Umi4Life/DP65/DP65_PCB/DP65.csv

Reference | Qty | Value | LCSC | DNP | Exclude from BOM | Exclude from Board | Footprint | Datasheet
K_PIPE1,K_TAB1 | 2 | choc_v1_SW_HS | C5333465 |  |  |  | PCM_Switch_Keyboard_Hotswap_Kailh:SW_Hotswap_Kailh_Choc_V1V2_1.50u | ~
K_ENTER1,K_SHIFT1,K_SPACE_L1,K_SPACE_R1 | 4 | choc_v1_SW_HS | C5333465 |  |  |  | PCM_Switch_Keyboard_Hotswap_Kailh:SW_Hotswap_Kailh_Choc_V1V2_2.25u | ~
K_CAPS1,K_SHIFT2 | 2 | choc_v1_SW_HS | C5333465 |  |  |  | PCM_Switch_Keyboard_Hotswap_Kailh:SW_Hotswap_Kailh_Choc_V1V2_1.75u | ~
K_BACKSPACE1 | 1 | choc_v1_SW_HS | C5333465 |  |  |  | PCM_Switch_Keyboard_Hotswap_Kailh:SW_Hotswap_Kailh_Choc_V1V2_2.00u | ~
K_ALT_L1,K_ALT_R1,K_CRTL1,K_FN1,K_FN2,K_WIN1 | 6 | choc_v1_SW_HS | C5333465 |  |  |  | PCM_Switch_Keyboard_Hotswap_Kailh:SW_Hotswap_Kailh_Choc_V1V2_1.25u | ~
K_0,K_1,K_2,K_3,K_4,K_5,K_6,K_7,K_8,K_9,K_A1,K_B1,K_C1,K_COMMA1,K_D1,K_DOWN_ARR1,K_E1,K_ESC1,K_F1,K_G1,K_H1,K_I1,K_J1,K_K1,K_L1,K_LEFT_ARR1,K_L_BRAC1,K_M1,K_MINUS1,K_N1,K_O1,K_P1,K_PERIOD1,K_PLUS1,K_Q1,K_QUOTE1,K_R1,K_RIGHT_ARR1,K_R_BRAC1,K_S1,K_SEMICOLON1,K_SLASH1,K_T1,K_U1,K_UP_ARR1,K_V1,K_W1,K_X1,K_Y1,K_Z1 | 50 | choc_v1_SW_HS | C5333465 |  |  |  | PCM_Switch_Keyboard_Hotswap_Kailh:SW_Hotswap_Kailh_Choc_V1V2_1.00u | ~
ENC_LEFT1,ENC_RIGHT1 | 2 | AS5600 | C499458 |  |  |  | AS5600:SOIC8
RST_SW1,RST_SW2 | 2 | SW_Push | C383800 |  |  |  | Button_Switch_THT:SW_Tactile_SKHH_Angled | ~
J1,J2 | 2 | Conn_01x02 | C295747 |  |  |  | Connector_JST:JST_PH_S2B-PH-SM4-TB_1x02-1MP_P2.00mm_Horizontal | ~
BAT_SW_L1,BAT_SW_R1 | 2 | SW_Push | C221530 |  |  |  | Button_Switch_THT:SW_Slide_SPDT_Angled_CK_OS102011MA1Q | ~
D1,D2,D3,D4,D5,D6,D7,D8,D9,D10,D11,D12,D13,D14,D15,D16,D17,D18,D19,D20,D21,D22,D23,D24,D25,D26,D27,D28,D29,D30,D31,D32,D33,D34,D35,D36,D37,D38,D39,D40,D41,D42,D43,D44,D45,D46,D47,D48,D49,D50,D51,D52,D53,D54,D55,D56,D57,D58,D59,D60,D61,D62,D63,D64,D65 | 65 | D_Small | C81598 |  |  |  | Diode_SMD:D_SOD-123 | ~
C5,C6,C7,C8 | 4 | 100nF | C49678 |  |  |  | Capacitor_SMD:C_0805_2012Metric_Pad1.18x1.45mm_HandSolder | ~
R1,R2,R3,R4 | 4 | 10k | C17414 |  |  |  | Resistor_SMD:R_0805_2012Metric | ~
NANO_LEFT1,NANO_RIGHT1 | 2 | nice_nano |  |  | Excluded from BOM |  | PCM_marbastlib-xp-promicroish:nice_nano_AH_USBup | https://nicekeyboards.com/docs/nice-nano/pinout-schematic
Display_LEFT1,Display_RIGHT1 | 2 | nice!view |  |  |  |  | Connector_PinHeader_2.54mm:PinHeader_1x05_P2.54mm_Vertical | https://nicekeyboards.com/docs/nice-view/pinout-schematic
