Umi4Life/DP65/DP65_PCB/AS5600/AS5600.step

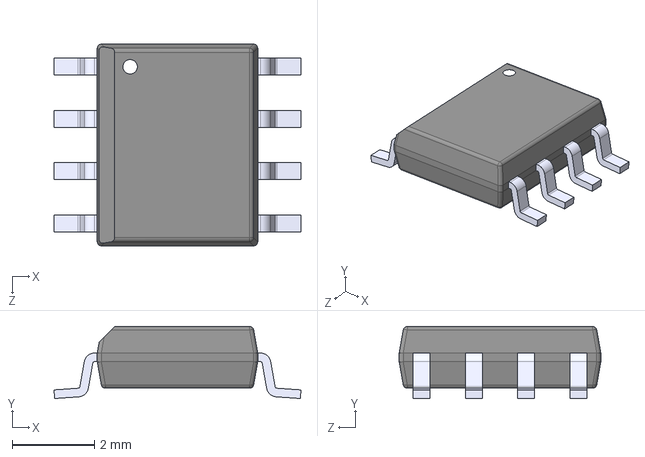
[picture p1: CAD file, 2026-10-15]
DP65_PCB/AS5600/AS5600.step
6.00 x 1.75 x 4.90 mm
