Umi4Life/DP65/DP65_PCB/DP65.step

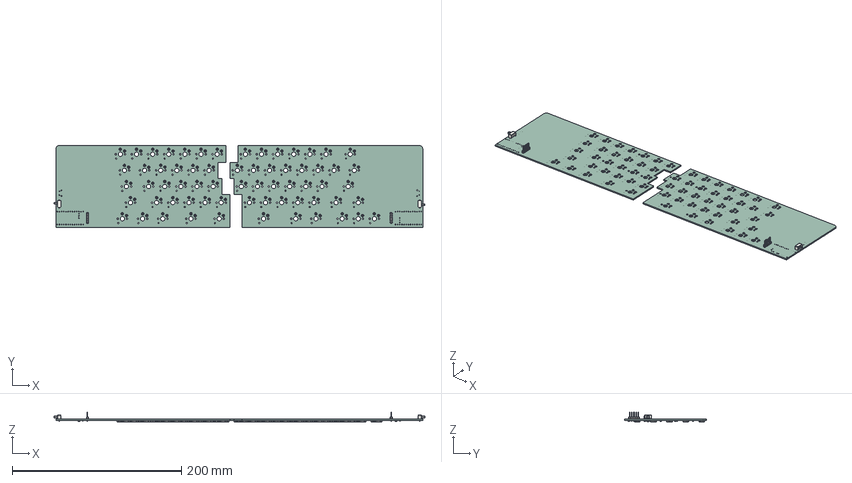
[picture p2: CAD file, 2026-10-15]
DP65_PCB/DP65.step
438.2 x 96.8 x 12.0 mm
SW_Hotswap_Kailh_Choc_V1 x 65
SW_Slide_SPDT_Angled_CK_OS102011MA1Q x 2
PinHeader_1x05_P2.54mm_Vertical x 2
D_SOD-123 x 65
R_0805_2012Metric x 4
C_0805_2012Metric x 4
DP65_PCB_1
DP65_PCB_2
