Umi4Life/DP65/DP65_PCB/gerber/DP65-Edge_Cuts.dxf

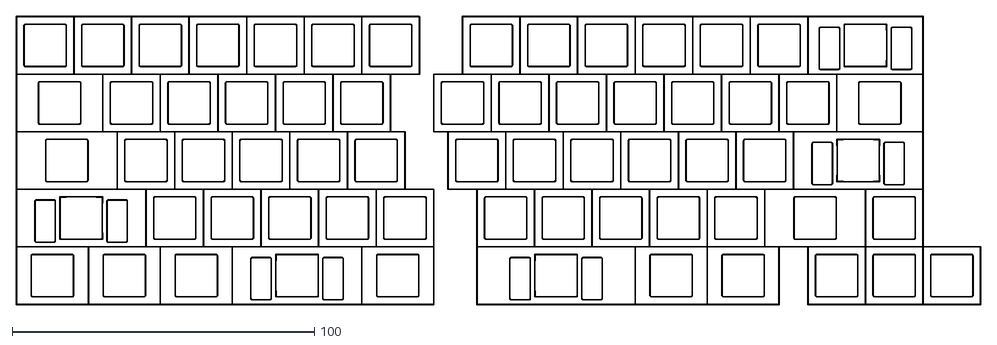
[picture p3: CAD file, 2026-10-15]
DP65_PCB/gerber/DP65-Edge_Cuts.dxf
319.2 x 95.4
