Umi4Life/DP65/DP65_PCB/gerber/DP65-User_Comments.dxf

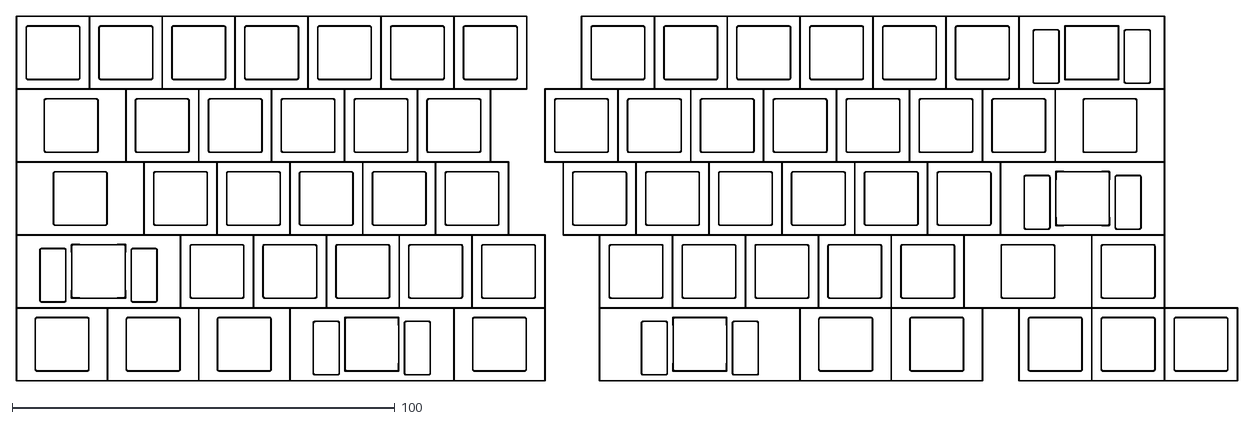
[picture p4: CAD file, 2026-10-15]
DP65_PCB/gerber/DP65-User_Comments.dxf
319.2 x 95.4
