Umi4Life/DP65/(list of files, cad)

Other CAD files:
DP65_CASE/DP65 Case v7.f3d
