Umi4Life/DP65/DP65_PCB/DP65.kicad_pcb

## KiCad design DP65_PCB/DP65.kicad_pcb (2026-10-15)

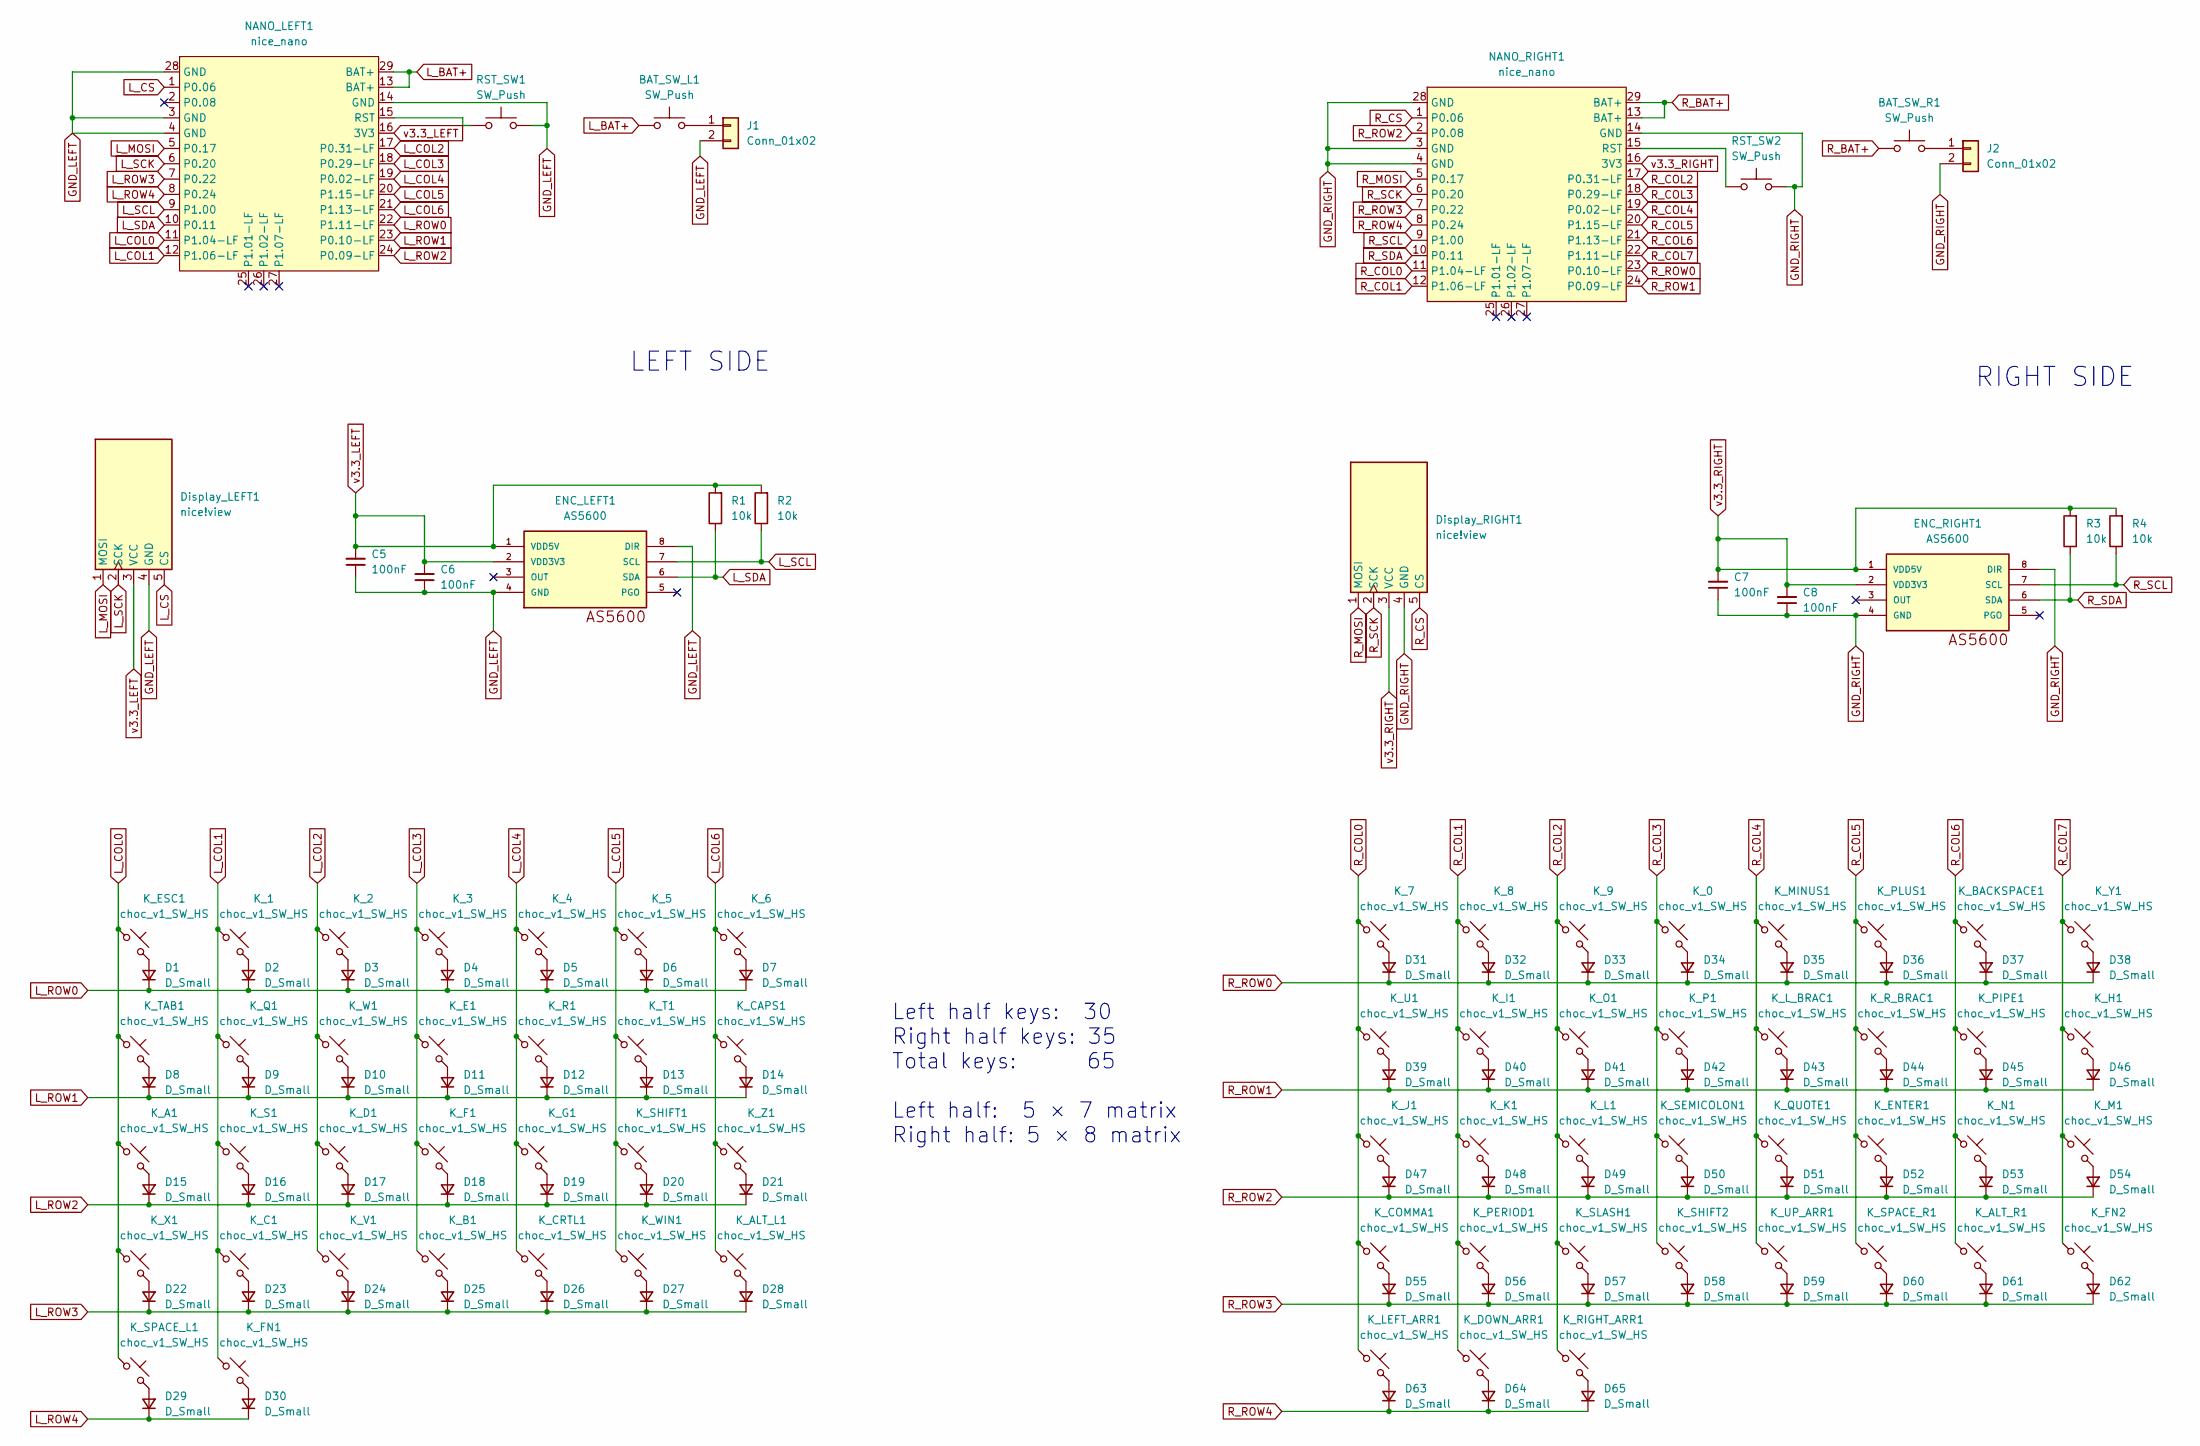
[picture p5: schematic DP65.kicad_sch]

Parts:
BAT_SW_L1: SW_Push; SW_Slide_SPDT_Angled_CK_OS102011MA1Q; LCSC C221530
BAT_SW_R1: SW_Push; SW_Slide_SPDT_Angled_CK_OS102011MA1Q; LCSC C221530
C5, C6, C7, C8: 100nF; C_0805_2012Metric_Pad1.18x1.45mm_HandSolder; LCSC C49678
D1, D2, D3, D4, D5, D6, D7, D8, D9, D10, D11, D12, D13, D14, D15, D16, D17, D18, D19, D20, D21, D22, D23, D24, D25, D26, D27, D28, D29, D30, D31, D32, D33, D34, D35, D36, D37, D38, D39, D40, D41, D42, D43, D44, D45, D46, D47, D48, D49, D50, D51, D52, D53, D54, D55, D56, D57, D58, D59, D60, D61, D62, D63, D64, D65: D_Small; D_SOD-123; LCSC C81598
Display_LEFT1: nice!view; PinHeader_1x05_P2.54mm_Vertical
Display_RIGHT1: nice!view; PinHeader_1x05_P2.54mm_Vertical
ENC_LEFT1: AS5600; SOIC8; LCSC C499458
ENC_RIGHT1: AS5600; SOIC8; LCSC C499458
J1, J2: Conn_01x02; JST_PH_S2B-PH-SM4-TB_1x02-1MP_P2.00mm_Horizontal; LCSC C295747
K_0, K_1, K_2, K_3, K_4, K_5, K_6, K_7, K_8, K_9: choc_v1_SW_HS; SW_Hotswap_Kailh_Choc_V1V2_1.00u; LCSC C5333465
K_A1: choc_v1_SW_HS; SW_Hotswap_Kailh_Choc_V1V2_1.00u; LCSC C5333465
K_ALT_L1: choc_v1_SW_HS; SW_Hotswap_Kailh_Choc_V1V2_1.25u; LCSC C5333465
K_ALT_R1: choc_v1_SW_HS; SW_Hotswap_Kailh_Choc_V1V2_1.25u; LCSC C5333465
K_B1: choc_v1_SW_HS; SW_Hotswap_Kailh_Choc_V1V2_1.00u; LCSC C5333465
K_BACKSPACE1: choc_v1_SW_HS; SW_Hotswap_Kailh_Choc_V1V2_2.00u; LCSC C5333465
K_C1: choc_v1_SW_HS; SW_Hotswap_Kailh_Choc_V1V2_1.00u; LCSC C5333465
K_CAPS1: choc_v1_SW_HS; SW_Hotswap_Kailh_Choc_V1V2_1.75u; LCSC C5333465
K_COMMA1: choc_v1_SW_HS; SW_Hotswap_Kailh_Choc_V1V2_1.00u; LCSC C5333465
K_CRTL1: choc_v1_SW_HS; SW_Hotswap_Kailh_Choc_V1V2_1.25u; LCSC C5333465
K_D1: choc_v1_SW_HS; SW_Hotswap_Kailh_Choc_V1V2_1.00u; LCSC C5333465
K_DOWN_ARR1: choc_v1_SW_HS; SW_Hotswap_Kailh_Choc_V1V2_1.00u; LCSC C5333465
K_E1: choc_v1_SW_HS; SW_Hotswap_Kailh_Choc_V1V2_1.00u; LCSC C5333465
K_ENTER1: choc_v1_SW_HS; SW_Hotswap_Kailh_Choc_V1V2_2.25u; LCSC C5333465
K_ESC1: choc_v1_SW_HS; SW_Hotswap_Kailh_Choc_V1V2_1.00u; LCSC C5333465
K_F1: choc_v1_SW_HS; SW_Hotswap_Kailh_Choc_V1V2_1.00u; LCSC C5333465
K_FN1, K_FN2: choc_v1_SW_HS; SW_Hotswap_Kailh_Choc_V1V2_1.25u; LCSC C5333465
K_G1: choc_v1_SW_HS; SW_Hotswap_Kailh_Choc_V1V2_1.00u; LCSC C5333465
K_H1: choc_v1_SW_HS; SW_Hotswap_Kailh_Choc_V1V2_1.00u; LCSC C5333465
K_I1: choc_v1_SW_HS; SW_Hotswap_Kailh_Choc_V1V2_1.00u; LCSC C5333465
K_J1: choc_v1_SW_HS; SW_Hotswap_Kailh_Choc_V1V2_1.00u; LCSC C5333465
K_K1: choc_v1_SW_HS; SW_Hotswap_Kailh_Choc_V1V2_1.00u; LCSC C5333465
K_L1: choc_v1_SW_HS; SW_Hotswap_Kailh_Choc_V1V2_1.00u; LCSC C5333465
K_LEFT_ARR1: choc_v1_SW_HS; SW_Hotswap_Kailh_Choc_V1V2_1.00u; LCSC C5333465
K_L_BRAC1: choc_v1_SW_HS; SW_Hotswap_Kailh_Choc_V1V2_1.00u; LCSC C5333465
K_M1: choc_v1_SW_HS; SW_Hotswap_Kailh_Choc_V1V2_1.00u; LCSC C5333465
K_MINUS1: choc_v1_SW_HS; SW_Hotswap_Kailh_Choc_V1V2_1.00u; LCSC C5333465
K_N1: choc_v1_SW_HS; SW_Hotswap_Kailh_Choc_V1V2_1.00u; LCSC C5333465
K_O1: choc_v1_SW_HS; SW_Hotswap_Kailh_Choc_V1V2_1.00u; LCSC C5333465
K_P1: choc_v1_SW_HS; SW_Hotswap_Kailh_Choc_V1V2_1.00u; LCSC C5333465
K_PERIOD1: choc_v1_SW_HS; SW_Hotswap_Kailh_Choc_V1V2_1.00u; LCSC C5333465
K_PIPE1: choc_v1_SW_HS; SW_Hotswap_Kailh_Choc_V1V2_1.50u; LCSC C5333465
K_PLUS1: choc_v1_SW_HS; SW_Hotswap_Kailh_Choc_V1V2_1.00u; LCSC C5333465
K_Q1: choc_v1_SW_HS; SW_Hotswap_Kailh_Choc_V1V2_1.00u; LCSC C5333465
K_QUOTE1: choc_v1_SW_HS; SW_Hotswap_Kailh_Choc_V1V2_1.00u; LCSC C5333465
K_R1: choc_v1_SW_HS; SW_Hotswap_Kailh_Choc_V1V2_1.00u; LCSC C5333465
K_RIGHT_ARR1: choc_v1_SW_HS; SW_Hotswap_Kailh_Choc_V1V2_1.00u; LCSC C5333465
K_R_BRAC1: choc_v1_SW_HS; SW_Hotswap_Kailh_Choc_V1V2_1.00u; LCSC C5333465
K_S1: choc_v1_SW_HS; SW_Hotswap_Kailh_Choc_V1V2_1.00u; LCSC C5333465
K_SEMICOLON1: choc_v1_SW_HS; SW_Hotswap_Kailh_Choc_V1V2_1.00u; LCSC C5333465
K_SHIFT1: choc_v1_SW_HS; SW_Hotswap_Kailh_Choc_V1V2_2.25u; LCSC C5333465
K_SHIFT2: choc_v1_SW_HS; SW_Hotswap_Kailh_Choc_V1V2_1.75u; LCSC C5333465
K_SLASH1: choc_v1_SW_HS; SW_Hotswap_Kailh_Choc_V1V2_1.00u; LCSC C5333465
K_SPACE_L1: choc_v1_SW_HS; SW_Hotswap_Kailh_Choc_V1V2_2.25u; LCSC C5333465
K_SPACE_R1: choc_v1_SW_HS; SW_Hotswap_Kailh_Choc_V1V2_2.25u; LCSC C5333465
K_T1: choc_v1_SW_HS; SW_Hotswap_Kailh_Choc_V1V2_1.00u; LCSC C5333465
K_TAB1: choc_v1_SW_HS; SW_Hotswap_Kailh_Choc_V1V2_1.50u; LCSC C5333465
K_U1: choc_v1_SW_HS; SW_Hotswap_Kailh_Choc_V1V2_1.00u; LCSC C5333465
K_UP_ARR1: choc_v1_SW_HS; SW_Hotswap_Kailh_Choc_V1V2_1.00u; LCSC C5333465
K_V1: choc_v1_SW_HS; SW_Hotswap_Kailh_Choc_V1V2_1.00u; LCSC C5333465
K_W1: choc_v1_SW_HS; SW_Hotswap_Kailh_Choc_V1V2_1.00u; LCSC C5333465
K_WIN1: choc_v1_SW_HS; SW_Hotswap_Kailh_Choc_V1V2_1.25u; LCSC C5333465
K_X1: choc_v1_SW_HS; SW_Hotswap_Kailh_Choc_V1V2_1.00u; LCSC C5333465
K_Y1: choc_v1_SW_HS; SW_Hotswap_Kailh_Choc_V1V2_1.00u; LCSC C5333465
K_Z1: choc_v1_SW_HS; SW_Hotswap_Kailh_Choc_V1V2_1.00u; LCSC C5333465
NANO_LEFT1: nice_nano; nice_nano_AH_USBup
NANO_RIGHT1: nice_nano; nice_nano_AH_USBup
R1, R2, R3, R4: 10k; R_0805_2012Metric; LCSC C17414
RST_SW1, RST_SW2: SW_Push; SW_Tactile_SKHH_Angled; LCSC C383800

Connections:
GND_LEFT: C5.1, C6.1, Display_LEFT1.4 (GND), ENC_LEFT1.4 (GND), ENC_LEFT1.8 (DIR), J1.2, NANO_LEFT1.3 (GND), NANO_LEFT1.4 (GND), NANO_LEFT1.14 (GND), NANO_LEFT1.28 (GND), RST_SW1.2
GND_RIGHT: C7.1, C8.1, Display_RIGHT1.4 (GND), ENC_RIGHT1.4 (GND), ENC_RIGHT1.8 (DIR), J2.2, NANO_RIGHT1.3 (GND), NANO_RIGHT1.4 (GND), NANO_RIGHT1.14 (GND), NANO_RIGHT1.28 (GND), RST_SW2.2
L_BAT+: BAT_SW_L1.1, NANO_LEFT1.13 (BAT+), NANO_LEFT1.29 (BAT+)
L_COL0: K_A1.1, K_ESC1.1, K_SPACE_L1.1, K_TAB1.1, K_X1.1, NANO_LEFT1.11 (P1.04-LF)
L_COL1: K_1.1, K_C1.1, K_FN1.1, K_Q1.1, K_S1.1, NANO_LEFT1.12 (P1.06-LF)
L_COL2: K_2.1, K_D1.1, K_V1.1, K_W1.1, NANO_LEFT1.17 (P0.31-LF)
L_COL3: K_3.1, K_B1.1, K_E1.1, K_F1.1, NANO_LEFT1.18 (P0.29-LF)
L_COL4: K_4.1, K_CRTL1.1, K_G1.1, K_R1.1, NANO_LEFT1.19 (P0.02-LF)
L_COL5: K_5.1, K_SHIFT1.1, K_T1.1, K_WIN1.1, NANO_LEFT1.20 (P1.15-LF)
L_COL6: K_6.1, K_ALT_L1.1, K_CAPS1.1, K_Z1.1, NANO_LEFT1.21 (P1.13-LF)
L_CS: Display_LEFT1.5 (CS), NANO_LEFT1.1 (P0.06)
L_MOSI: Display_LEFT1.1 (MOSI), NANO_LEFT1.5 (P0.17)
L_ROW0: D1.1 (K), D2.1 (K), D3.1 (K), D4.1 (K), D5.1 (K), D6.1 (K), D7.1 (K), NANO_LEFT1.22 (P1.11-LF)
L_ROW1: D8.1 (K), D9.1 (K), D10.1 (K), D11.1 (K), D12.1 (K), D13.1 (K), D14.1 (K), NANO_LEFT1.23 (P0.10-LF)
L_ROW2: D15.1 (K), D16.1 (K), D17.1 (K), D18.1 (K), D19.1 (K), D20.1 (K), D21.1 (K), NANO_LEFT1.24 (P0.09-LF)
L_ROW3: D22.1 (K), D23.1 (K), D24.1 (K), D25.1 (K), D26.1 (K), D27.1 (K), D28.1 (K), NANO_LEFT1.7 (P0.22)
L_ROW4: D29.1 (K), D30.1 (K), NANO_LEFT1.8 (P0.24)
L_SCK: Display_LEFT1.2 (SCK), NANO_LEFT1.6 (P0.20)
L_SCL: ENC_LEFT1.7 (SCL), NANO_LEFT1.9 (P1.00), R2.1
L_SDA: ENC_LEFT1.6 (SDA), NANO_LEFT1.10 (P0.11), R1.1
unnamed: D1.2 (A), K_ESC1.2
unnamed: D2.2 (A), K_1.2
unnamed: D3.2 (A), K_2.2
unnamed: D4.2 (A), K_3.2
unnamed: D5.2 (A), K_4.2
unnamed: D6.2 (A), K_5.2
unnamed: D7.2 (A), K_6.2
unnamed: D8.2 (A), K_TAB1.2
unnamed: D9.2 (A), K_Q1.2
unnamed: D10.2 (A), K_W1.2
unnamed: D11.2 (A), K_E1.2
unnamed: D12.2 (A), K_R1.2
unnamed: D13.2 (A), K_T1.2
unnamed: D14.2 (A), K_CAPS1.2
unnamed: D15.2 (A), K_A1.2
unnamed: D16.2 (A), K_S1.2
unnamed: D17.2 (A), K_D1.2
unnamed: D18.2 (A), K_F1.2
unnamed: D19.2 (A), K_G1.2
unnamed: D20.2 (A), K_SHIFT1.2
unnamed: D21.2 (A), K_Z1.2
unnamed: D22.2 (A), K_X1.2
unnamed: D23.2 (A), K_C1.2
unnamed: D24.2 (A), K_V1.2
unnamed: D25.2 (A), K_B1.2
unnamed: D26.2 (A), K_CRTL1.2
unnamed: D27.2 (A), K_WIN1.2
unnamed: D28.2 (A), K_ALT_L1.2
unnamed: D29.2 (A), K_SPACE_L1.2
unnamed: D30.2 (A), K_FN1.2
unnamed: D31.2 (A), K_7.2
unnamed: D32.2 (A), K_8.2
unnamed: D33.2 (A), K_9.2
unnamed: D34.2 (A), K_0.2
unnamed: D35.2 (A), K_MINUS1.2
unnamed: D36.2 (A), K_PLUS1.2
unnamed: D37.2 (A), K_BACKSPACE1.2
unnamed: D38.2 (A), K_Y1.2
unnamed: D39.2 (A), K_U1.2
unnamed: D40.2 (A), K_I1.2
unnamed: D41.2 (A), K_O1.2
unnamed: D42.2 (A), K_P1.2
unnamed: D43.2 (A), K_L_BRAC1.2
unnamed: D44.2 (A), K_R_BRAC1.2
unnamed: D45.2 (A), K_PIPE1.2
unnamed: D46.2 (A), K_H1.2
unnamed: D47.2 (A), K_J1.2
unnamed: D48.2 (A), K_K1.2
unnamed: D49.2 (A), K_L1.2
unnamed: D50.2 (A), K_SEMICOLON1.2
unnamed: D51.2 (A), K_QUOTE1.2
unnamed: D52.2 (A), K_ENTER1.2
unnamed: D53.2 (A), K_N1.2
unnamed: D54.2 (A), K_M1.2
unnamed: D55.2 (A), K_COMMA1.2
unnamed: D56.2 (A), K_PERIOD1.2
unnamed: D57.2 (A), K_SLASH1.2
unnamed: D58.2 (A), K_SHIFT2.2
unnamed: D59.2 (A), K_UP_ARR1.2
unnamed: D60.2 (A), K_SPACE_R1.2
unnamed: D61.2 (A), K_ALT_R1.2
unnamed: D62.2 (A), K_FN2.2
unnamed: D63.2 (A), K_LEFT_ARR1.2
unnamed: D64.2 (A), K_DOWN_ARR1.2
unnamed: D65.2 (A), K_RIGHT_ARR1.2
unnamed: BAT_SW_L1.2, J1.1
unnamed: BAT_SW_R1.2, J2.1
unnamed: NANO_LEFT1.15 (RST), RST_SW1.1
unnamed: NANO_RIGHT1.15 (RST), RST_SW2.1
R_BAT+: BAT_SW_R1.1, NANO_RIGHT1.13 (BAT+), NANO_RIGHT1.29 (BAT+)
R_COL0: K_7.1, K_COMMA1.1, K_J1.1, K_LEFT_ARR1.1, K_U1.1, NANO_RIGHT1.11 (P1.04-LF)
R_COL1: K_8.1, K_DOWN_ARR1.1, K_I1.1, K_K1.1, K_PERIOD1.1, NANO_RIGHT1.12 (P1.06-LF)
R_COL2: K_9.1, K_L1.1, K_O1.1, K_RIGHT_ARR1.1, K_SLASH1.1, NANO_RIGHT1.17 (P0.31-LF)
R_COL3: K_0.1, K_P1.1, K_SEMICOLON1.1, K_SHIFT2.1, NANO_RIGHT1.18 (P0.29-LF)
R_COL4: K_L_BRAC1.1, K_MINUS1.1, K_QUOTE1.1, K_UP_ARR1.1, NANO_RIGHT1.19 (P0.02-LF)
R_COL5: K_ENTER1.1, K_PLUS1.1, K_R_BRAC1.1, K_SPACE_R1.1, NANO_RIGHT1.20 (P1.15-LF)
R_COL6: K_ALT_R1.1, K_BACKSPACE1.1, K_N1.1, K_PIPE1.1, NANO_RIGHT1.21 (P1.13-LF)
R_COL7: K_FN2.1, K_H1.1, K_M1.1, K_Y1.1, NANO_RIGHT1.22 (P1.11-LF)
R_CS: Display_RIGHT1.5 (CS), NANO_RIGHT1.1 (P0.06)
R_MOSI: Display_RIGHT1.1 (MOSI), NANO_RIGHT1.5 (P0.17)
R_ROW0: D31.1 (K), D32.1 (K), D33.1 (K), D34.1 (K), D35.1 (K), D36.1 (K), D37.1 (K), D38.1 (K), NANO_RIGHT1.23 (P0.10-LF)
R_ROW1: D39.1 (K), D40.1 (K), D41.1 (K), D42.1 (K), D43.1 (K), D44.1 (K), D45.1 (K), D46.1 (K), NANO_RIGHT1.24 (P0.09-LF)
R_ROW2: D47.1 (K), D48.1 (K), D49.1 (K), D50.1 (K), D51.1 (K), D52.1 (K), D53.1 (K), D54.1 (K), NANO_RIGHT1.2 (P0.08)
R_ROW3: D55.1 (K), D56.1 (K), D57.1 (K), D58.1 (K), D59.1 (K), D60.1 (K), D61.1 (K), D62.1 (K), NANO_RIGHT1.7 (P0.22)
R_ROW4: D63.1 (K), D64.1 (K), D65.1 (K), NANO_RIGHT1.8 (P0.24)
R_SCK: Display_RIGHT1.2 (SCK), NANO_RIGHT1.6 (P0.20)
R_SCL: ENC_RIGHT1.7 (SCL), NANO_RIGHT1.9 (P1.00), R4.1
R_SDA: ENC_RIGHT1.6 (SDA), NANO_RIGHT1.10 (P0.11), R3.1
v3.3_LEFT: C5.2, C6.2, Display_LEFT1.3 (VCC), ENC_LEFT1.1 (VDD5V), ENC_LEFT1.2 (VDD3V3), NANO_LEFT1.16 (3V3), R1.2, R2.2
v3.3_RIGHT: C7.2, C8.2, Display_RIGHT1.3 (VCC), ENC_RIGHT1.1 (VDD5V), ENC_RIGHT1.2 (VDD3V3), NANO_RIGHT1.16 (3V3), R3.2, R4.2

Notes on the sheet:
RIGHT SIDE
Left half keys: 30 Right half keys: 35 Total keys: 65 Left half: 5 × 7 matrix Right half: 5 × 8 matrix
LEFT SIDE

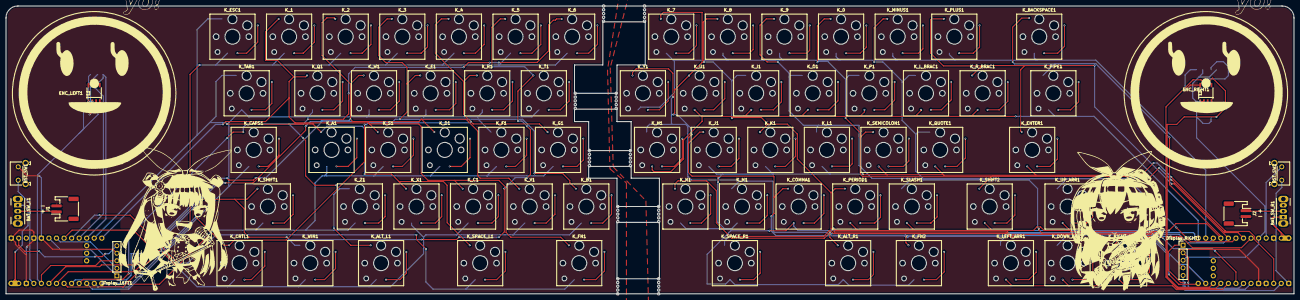
[picture p6: board DP65.kicad_pcb from above]

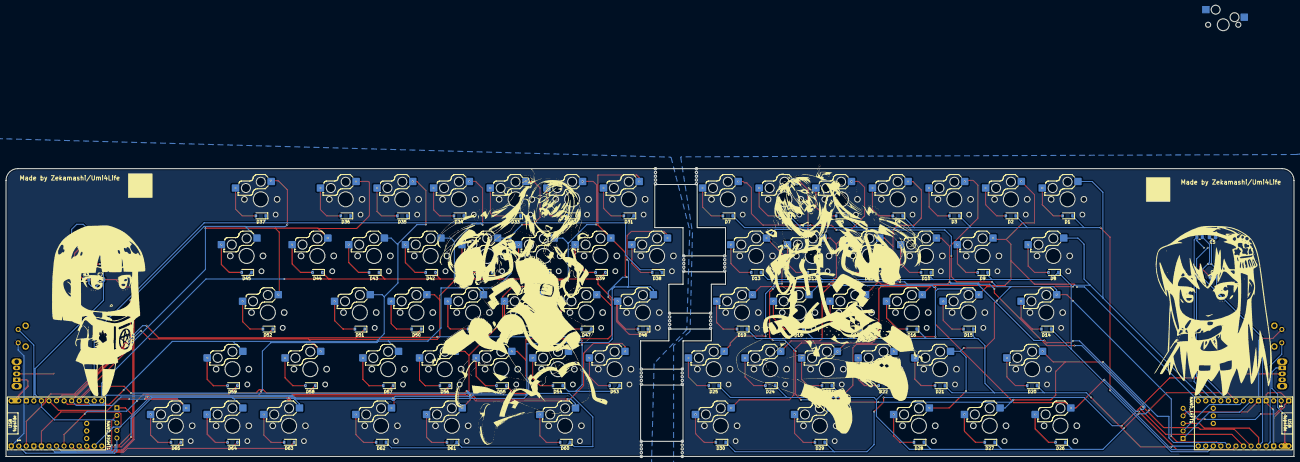
[picture p7: board DP65.kicad_pcb from below]

Board: 2 copper layers, 433.4 x 96.8 mm, 150 parts (75 on the bottom side), 110 nets.
